SpaceTeam/STS1_EPS_PROTO/STS1_EPS/STS1_EPS_PROTO_BCC_LTC4020/STS1_EPS_PROTO_BCC_LTC4020.kicad_pcb

## KiCad design STS1_EPS/STS1_EPS_PROTO_BCC_LTC4020/STS1_EPS_PROTO_BCC_LTC4020.kicad_pcb (2021-07-15)

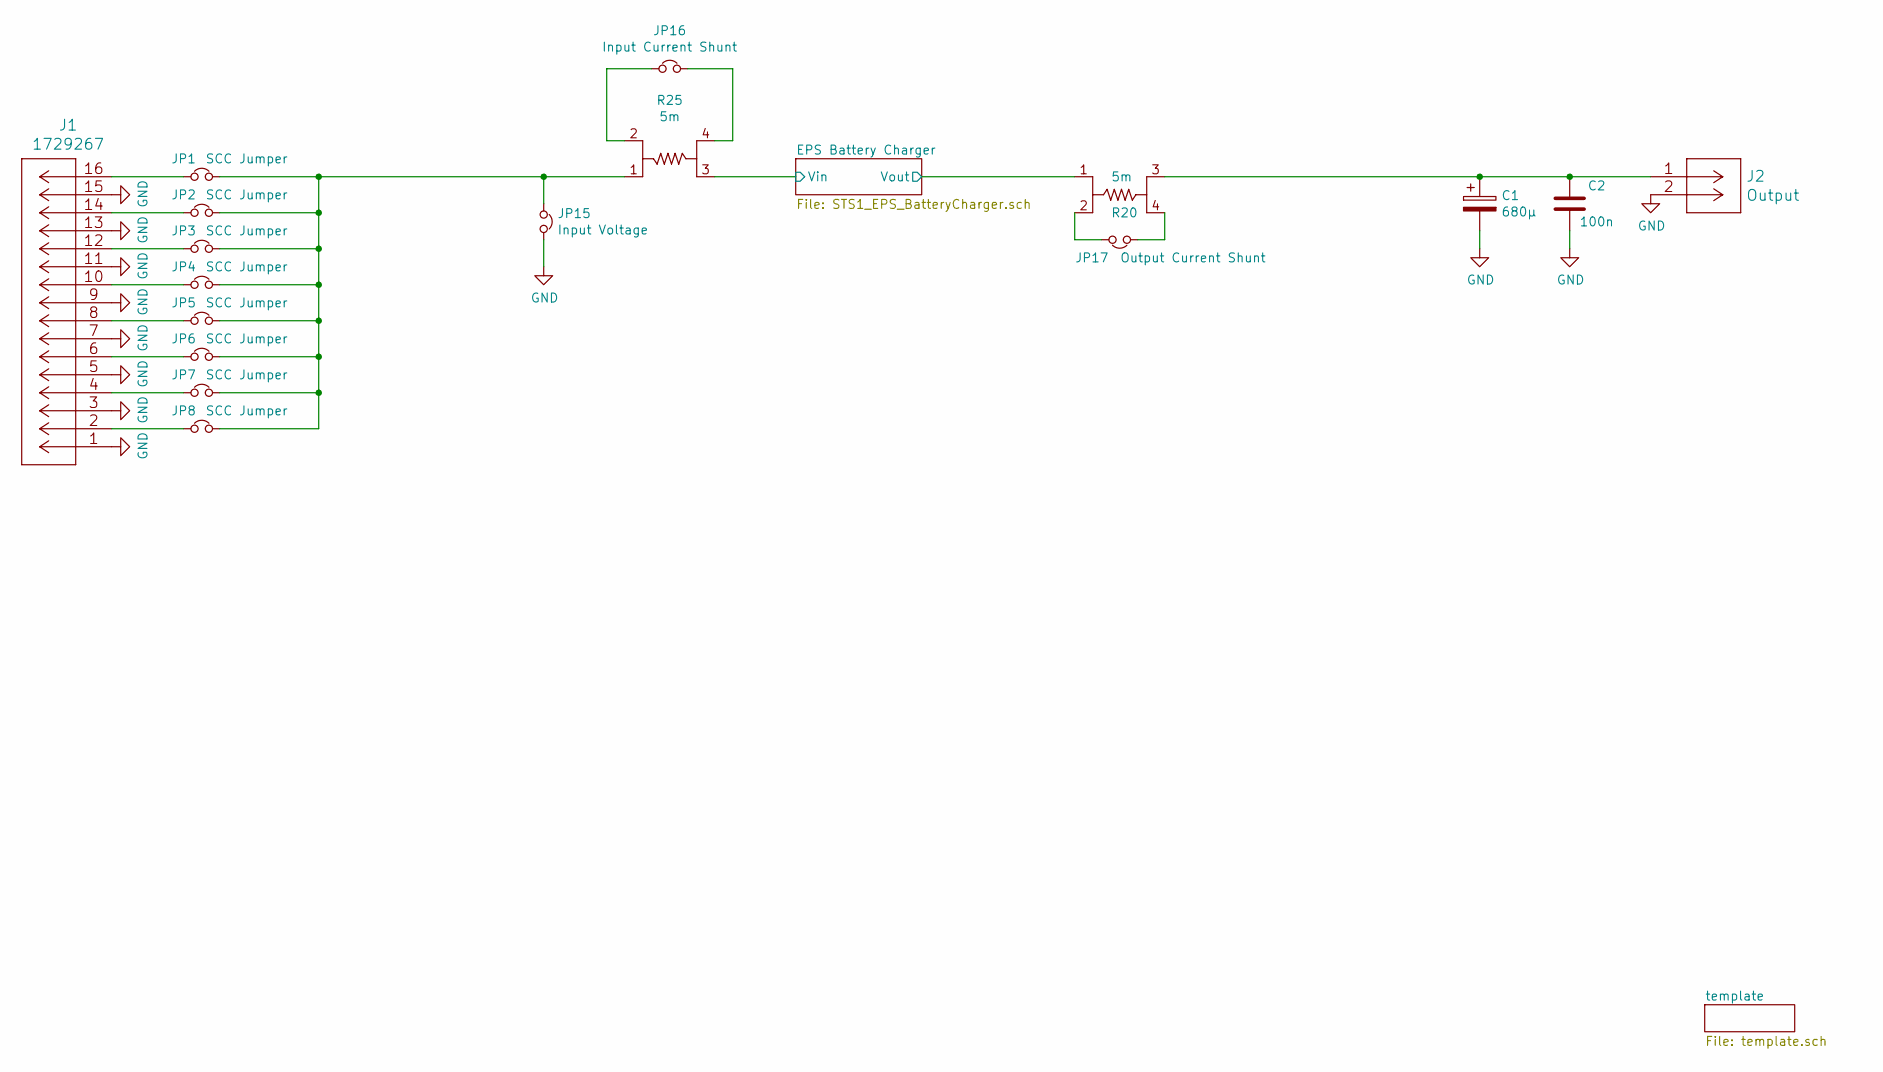
[picture p1: schematic STS1_EPS_PROTO_BCC_LTC4020.sch]

Parts:
C1: 680µ; CP_EIA-7361-438_AVX-U
C2: 100n; C_0805_2012Metric
J1: 1729267; 1984756
J2: Output; 1888807
JP1, JP2, JP3, JP4, JP5, JP6, JP7, JP8: SCC Jumper; PinHeader_1x02_P2.54mm_Vertical
JP15: Input Voltage; PinHeader_1x02_P2.54mm_Vertical
JP16: Input Current Shunt; PinHeader_1x02_P2.54mm_Vertical
JP17: Output Current Shunt; PinHeader_1x02_P2.54mm_Vertical
R20, R25: 5m; CST0612-FC-R002E

Connections:
/EPS Battery Charger/Vin: R25.3; also elsewhere on the board
/EPS Battery Charger/Vout: R20.1; also elsewhere on the board
GND: C1.2, C2.1, J1.1, J1.3, J1.5, J1.7, J1.9, J1.11, J1.13, J1.15, J2.2, JP15.2; also elsewhere on the board
unnamed: C1.1, C2.2, J2.1, R20.3
unnamed: J1.2, JP8.1
unnamed: J1.4, JP7.1
unnamed: J1.6, JP6.1
unnamed: J1.8, JP5.1
unnamed: J1.10, JP4.1
unnamed: J1.12, JP3.1
unnamed: J1.14, JP2.1
unnamed: J1.16, JP1.1
unnamed: JP1.2, JP2.2, JP3.2, JP4.2, JP5.2, JP6.2, JP7.2, JP8.2, JP15.1, R25.1
unnamed: JP16.1, R25.2
unnamed: JP16.2, R25.4
unnamed: JP17.1, R20.4
unnamed: JP17.2, R20.2

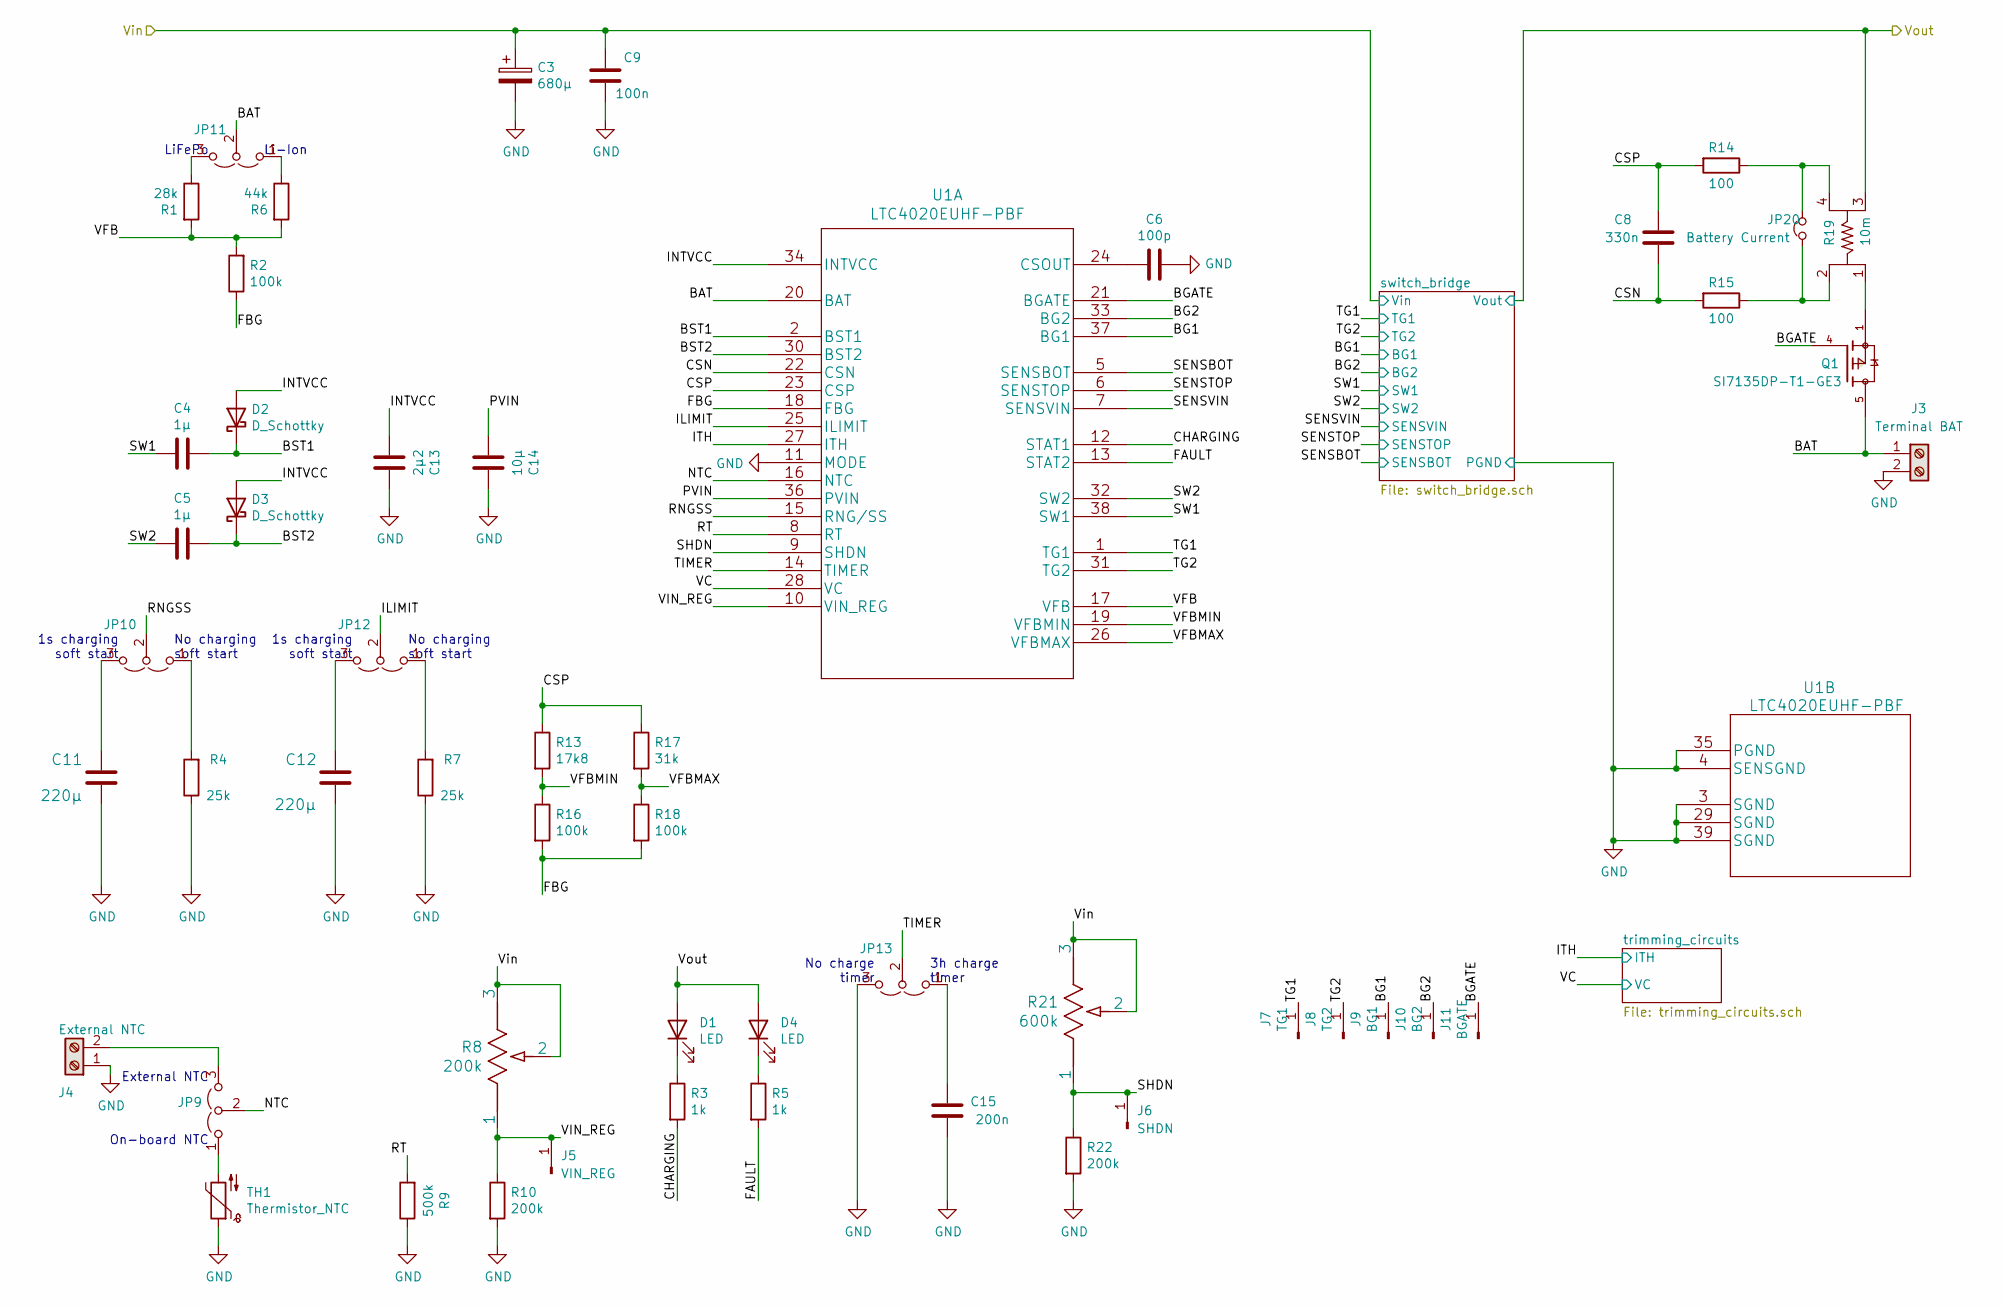
[picture p2: schematic STS1_EPS_BatteryCharger.sch, EPS Battery Charger]

Parts:
C3: 680µ; CP_EIA-7361-438_AVX-U
C4, C5: 1µ; C_0805_2012Metric
C6: 100p; C_0805_2012Metric
C8: 330n; C_0805_2012Metric
C9: 100n; C_0805_2012Metric
C11, C12: 220µ; CP_EIA-3528-12_Kemet-T
C13: 2µ2; C_0805_2012Metric
C14: 10µ; C_0805_2012Metric
C15: 200n; C_0805_2012Metric
D1, D4: LED; LED_0805_2012Metric
D2, D3: D_Schottky; RB168MM-40TFTR
J3: Terminal BAT; 1725656
J4: External NTC; 1725656
J5: VIN_REG; PinHeader_1x01_P2.54mm_Vertical
J6: SHDN; PinHeader_1x01_P2.54mm_Vertical
J7: TG1; PinHeader_1x01_P2.54mm_Vertical
J8: TG2; PinHeader_1x01_P2.54mm_Vertical
J9: BG1; PinHeader_1x01_P2.54mm_Vertical
J10: BG2; PinHeader_1x01_P2.54mm_Vertical
J11: BGATE; PinHeader_1x01_P2.54mm_Vertical
JP9, JP10, JP11, JP12, JP13: Jumper_3_Open; PinHeader_1x03_P2.54mm_Vertical
JP20: Battery Current; PinHeader_1x02_P2.54mm_Vertical
Q1: SI7135DP-T1-GE3; TRANS_SI7135DP-T1-GE3; PARTREV A
R1: 28k; R_0805_2012Metric
R2, R16, R18: 100k; R_0805_2012Metric
R3, R5: 1k; R_0805_2012Metric
R4, R7: 25k; R_0805_2012Metric
R6: 44k; R_0805_2012Metric
R8: 200k; TS53YL 20K 20&percent_
R9: 500k; R_0805_2012Metric
R10, R22: 200k; R_0805_2012Metric
R13: 17k8; R_0805_2012Metric
R14, R15: 100; R_0805_2012Metric
R17: 31k; R_0805_2012Metric
R19: 10m; CST0612-FC-R002E
R21: 600k; TS53YL 20K 20&percent_
TH1: Thermistor_NTC; R_0603_1608Metric
U1: LTC4020EUHF-PBF

Connections:
/EPS Battery Charger/BAT: J3.1, JP11.2 (C), Q1.5, U1.20 (BAT)
/EPS Battery Charger/BG1: J9.1, U1.37 (BG1); also elsewhere on the board
/EPS Battery Charger/BG2: J10.1, U1.33 (BG2); also elsewhere on the board
/EPS Battery Charger/BGATE: J11.1, Q1.4, U1.21 (BGATE)
/EPS Battery Charger/BST1: C4.1, D2.1 (K), U1.2 (BST1)
/EPS Battery Charger/BST2: C5.1, D3.1 (K), U1.30 (BST2)
/EPS Battery Charger/CHARGING: R3.2, U1.12 (STAT1)
/EPS Battery Charger/CSN: C8.2, R15.2, U1.22 (CSN)
/EPS Battery Charger/CSP: C8.1, R13.1, R14.2, R17.1, U1.23 (CSP)
/EPS Battery Charger/FAULT: R5.2, U1.13 (STAT2)
/EPS Battery Charger/FBG: R2.1, R16.2, R18.2, U1.18 (FBG)
/EPS Battery Charger/ILIMIT: JP12.2 (C), U1.25 (ILIMIT)
/EPS Battery Charger/INTVCC: C13.2, D2.2 (A), D3.2 (A), U1.34 (INTVCC)
/EPS Battery Charger/ITH: U1.27 (ITH); also elsewhere on the board
/EPS Battery Charger/NTC: JP9.2 (C), U1.16 (NTC)
/EPS Battery Charger/PVIN: C14.2, U1.36 (PVIN)
/EPS Battery Charger/RNGSS: JP10.2 (C), U1.15 (RNG/SS)
/EPS Battery Charger/RT: R9.2, U1.8 (RT)
/EPS Battery Charger/SENSBOT: U1.5 (SENSBOT); also elsewhere on the board
/EPS Battery Charger/SENSTOP: U1.6 (SENSTOP); also elsewhere on the board
/EPS Battery Charger/SENSVIN: U1.7 (SENSVIN); also elsewhere on the board
/EPS Battery Charger/SHDN: J6.1, R21.1, R22.1, U1.9 (SHDN)
/EPS Battery Charger/SW1: C4.2, U1.38 (SW1); also elsewhere on the board
/EPS Battery Charger/SW2: C5.2, U1.32 (SW2); also elsewhere on the board
/EPS Battery Charger/TG1: J7.1, U1.1 (TG1); also elsewhere on the board
/EPS Battery Charger/TG2: J8.1, U1.31 (TG2); also elsewhere on the board
/EPS Battery Charger/TIMER: JP13.2 (C), U1.14 (TIMER)
/EPS Battery Charger/VC: U1.28 (VC); also elsewhere on the board
/EPS Battery Charger/VFB: R1.2, R2.2, R6.2, U1.17 (VFB)
/EPS Battery Charger/VFBMAX: R17.2, R18.1, U1.26 (VFBMAX)
/EPS Battery Charger/VFBMIN: R13.2, R16.1, U1.19 (VFBMIN)
/EPS Battery Charger/VIN_REG: J5.1, R8.1, R10.1, U1.10 (VIN_REG)
/EPS Battery Charger/Vin: C3.1, C9.2, R8.2, R8.3, R21.2, R21.3; also elsewhere on the board
/EPS Battery Charger/Vout: D1.2 (A), D4.2 (A), R19.3; also elsewhere on the board
GND: C3.2, C6.1, C9.1, C11.1, C12.1, C13.1, C14.1, C15.2, J3.2, J4.1, JP13.3 (B), R4.1, R7.1, R9.1, R10.2, R22.2, TH1.1, U1.3 (SGND), U1.4 (SENSGND), U1.11 (MODE), U1.29 (SGND), U1.35 (PGND), U1.39 (SGND); also elsewhere on the board
unnamed: C6.2, U1.24 (CSOUT)
unnamed: C11.2, JP10.3 (B)
unnamed: C12.2, JP12.3 (B)
unnamed: C15.1, JP13.1 (A)
unnamed: D1.1 (K), R3.1
unnamed: D4.1 (K), R5.1
unnamed: J4.2, JP9.3 (B)
unnamed: JP9.1 (A), TH1.2
unnamed: JP10.1 (A), R4.2
unnamed: JP11.1 (A), R6.1
unnamed: JP11.3 (B), R1.1
unnamed: JP12.1 (A), R7.2
unnamed: JP20.1, R15.1, R19.2
unnamed: JP20.2, R14.1, R19.4
unnamed: Q1.1, R19.1

Notes on the sheet:
LiFePo
Li-Ion
No charge timer
3h charge timer
External NTC
On-board NTC
No charging soft start
1s charging soft start

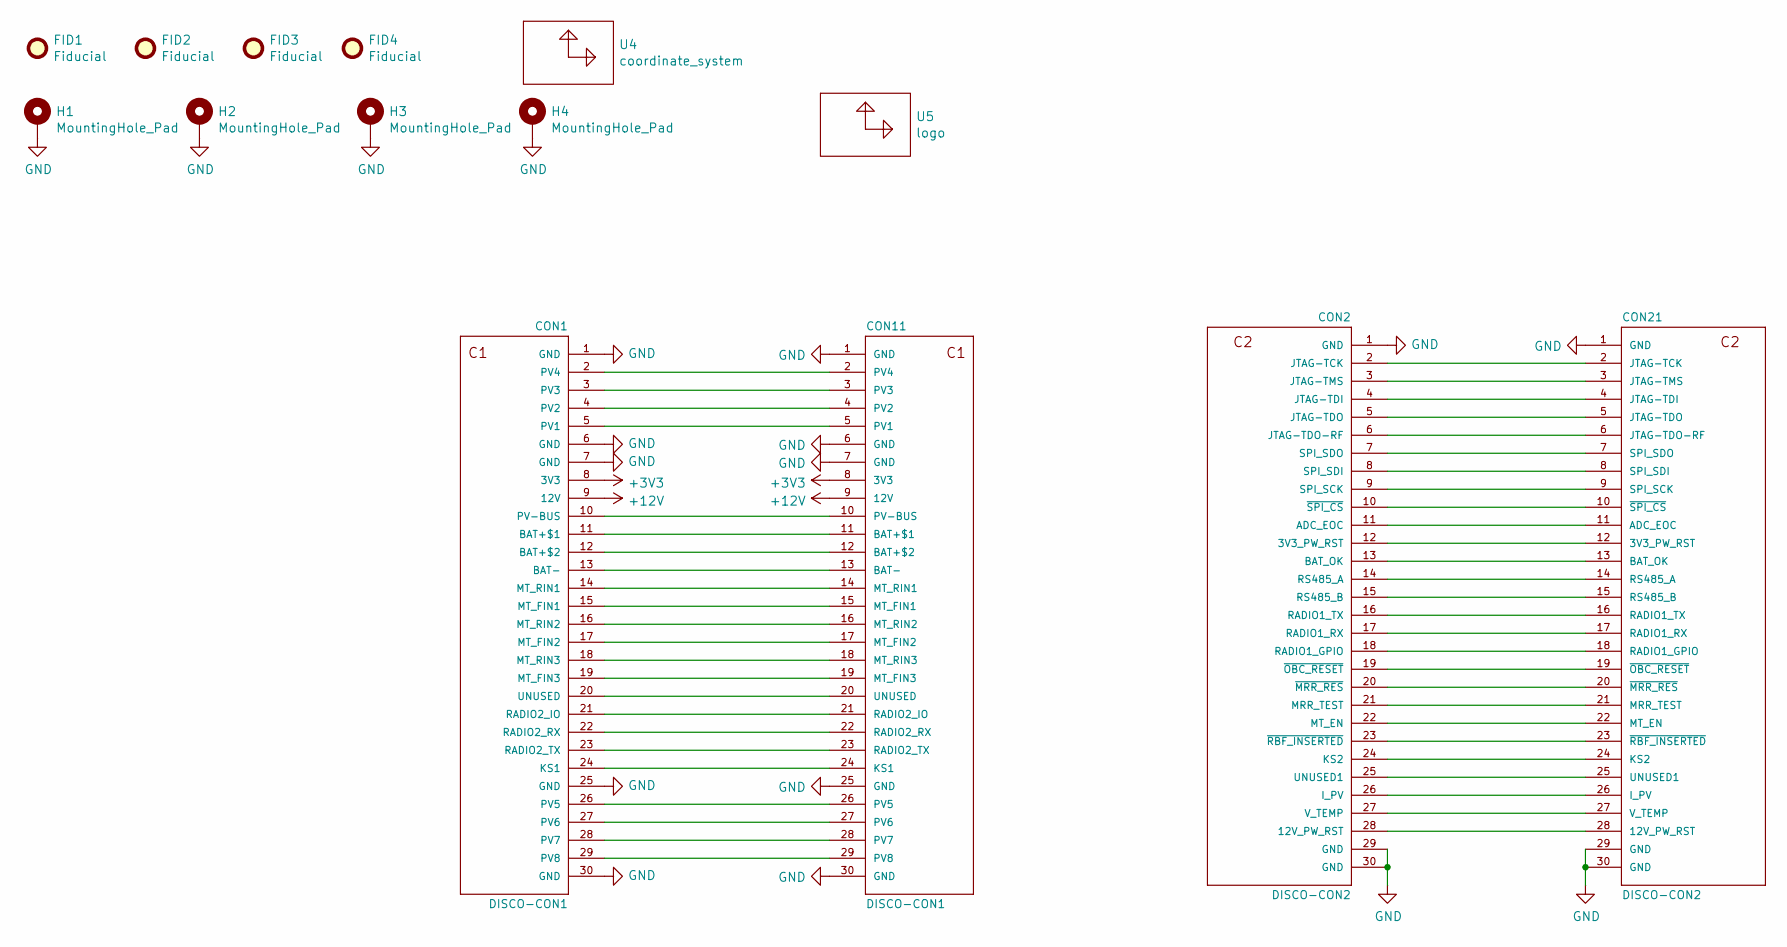
[picture p3: schematic template.sch]

Parts:
CON1, CON11: DISCO-CON1; Cubesatconnector
CON2, CON21: DISCO-CON2; Cubesatconnector
FID1, FID2, FID3, FID4: Fiducial; Fiducial_0.75mm_Mask1.5mm
H1, H2, H3, H4: MountingHole_Pad; MountingHole_3.2mm_M3_Pad_Via
U4: coordinate_system; Coordinates
U5: logo; STLogoTiny

Connections:
+3V3: CON1.8 (3V3), CON11.8 (3V3)
+12V: CON1.9 (12V), CON11.9 (12V)
GND: CON1.1 (GND), CON1.6 (GND), CON1.7 (GND), CON1.25 (GND), CON1.30 (GND), CON2.1 (GND), CON2.29 (GND), CON2.30 (GND), CON11.1 (GND), CON11.6 (GND), CON11.7 (GND), CON11.25 (GND), CON11.30 (GND), CON21.1 (GND), CON21.29 (GND), CON21.30 (GND), H1.1, H2.1, H3.1, H4.1; also elsewhere on the board
unnamed: CON1.2 (PV4), CON11.2 (PV4)
unnamed: CON1.3 (PV3), CON11.3 (PV3)
unnamed: CON1.4 (PV2), CON11.4 (PV2)
unnamed: CON1.5 (PV1), CON11.5 (PV1)
unnamed: CON1.10 (PV-BUS), CON11.10 (PV-BUS)
unnamed: CON1.11 (BAT+$1), CON11.11 (BAT+$1)
unnamed: CON1.12 (BAT+$2), CON11.12 (BAT+$2)
unnamed: CON1.13 (BAT-), CON11.13 (BAT-)
unnamed: CON1.14 (MT_RIN1), CON11.14 (MT_RIN1)
unnamed: CON1.15 (MT_FIN1), CON11.15 (MT_FIN1)
unnamed: CON1.16 (MT_RIN2), CON11.16 (MT_RIN2)
unnamed: CON1.17 (MT_FIN2), CON11.17 (MT_FIN2)
unnamed: CON1.18 (MT_RIN3), CON11.18 (MT_RIN3)
unnamed: CON1.19 (MT_FIN3), CON11.19 (MT_FIN3)
unnamed: CON1.20 (UNUSED), CON11.20 (UNUSED)
unnamed: CON1.21 (RADIO2_IO), CON11.21 (RADIO2_IO)
unnamed: CON1.22 (RADIO2_RX), CON11.22 (RADIO2_RX)
unnamed: CON1.23 (RADIO2_TX), CON11.23 (RADIO2_TX)
unnamed: CON1.24 (KS1), CON11.24 (KS1)
unnamed: CON1.26 (PV5), CON11.26 (PV5)
unnamed: CON1.27 (PV6), CON11.27 (PV6)
unnamed: CON1.28 (PV7), CON11.28 (PV7)
unnamed: CON1.29 (PV8), CON11.29 (PV8)
unnamed: CON2.2 (JTAG-TCK), CON21.2 (JTAG-TCK)
unnamed: CON2.3 (JTAG-TMS), CON21.3 (JTAG-TMS)
unnamed: CON2.4 (JTAG-TDI), CON21.4 (JTAG-TDI)
unnamed: CON2.5 (JTAG-TDO), CON21.5 (JTAG-TDO)
unnamed: CON2.6 (JTAG-TDO-RF), CON21.6 (JTAG-TDO-RF)
unnamed: CON2.7 (SPI_SDO), CON21.7 (SPI_SDO)
unnamed: CON2.8 (SPI_SDI), CON21.8 (SPI_SDI)
unnamed: CON2.9 (SPI_SCK), CON21.9 (SPI_SCK)
unnamed: CON2.10 (~SPI_CS), CON21.10 (~SPI_CS)
unnamed: CON2.11 (ADC_EOC), CON21.11 (ADC_EOC)
unnamed: CON2.12 (3V3_PW_RST), CON21.12 (3V3_PW_RST)
unnamed: CON2.13 (BAT_OK), CON21.13 (BAT_OK)
unnamed: CON2.14 (RS485_A), CON21.14 (RS485_A)
unnamed: CON2.15 (RS485_B), CON21.15 (RS485_B)
unnamed: CON2.16 (RADIO1_TX), CON21.16 (RADIO1_TX)
unnamed: CON2.17 (RADIO1_RX), CON21.17 (RADIO1_RX)
unnamed: CON2.18 (RADIO1_GPIO), CON21.18 (RADIO1_GPIO)
unnamed: CON2.19 (~OBC_RESET), CON21.19 (~OBC_RESET)
unnamed: CON2.20 (~MRR_RES), CON21.20 (~MRR_RES)
unnamed: CON2.21 (MRR_TEST), CON21.21 (MRR_TEST)
unnamed: CON2.22 (MT_EN), CON21.22 (MT_EN)
unnamed: CON2.23 (~RBF_INSERTED), CON21.23 (~RBF_INSERTED)
unnamed: CON2.24 (KS2), CON21.24 (KS2)
unnamed: CON2.25 (UNUSED1), CON21.25 (UNUSED1)
unnamed: CON2.26 (I_PV), CON21.26 (I_PV)
unnamed: CON2.27 (V_TEMP), CON21.27 (V_TEMP)
unnamed: CON2.28 (12V_PW_RST), CON21.28 (12V_PW_RST)

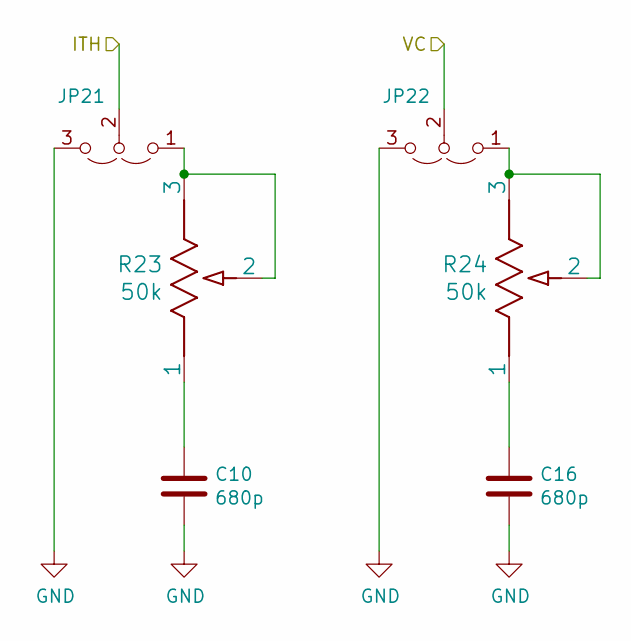
[picture p4: schematic trimming_circuits.sch]

Parts:
C10, C16: 680p; C_0805_2012Metric
JP21, JP22: Jumper_3_Open; PinHeader_1x03_P2.54mm_Vertical
R23, R24: 50k; TS53YL 20K 20&percent_

Connections:
/EPS Battery Charger/ITH: JP21.2 (C); also elsewhere on the board
/EPS Battery Charger/VC: JP22.2 (C); also elsewhere on the board
GND: C10.2, C16.2, JP21.3 (B), JP22.3 (B); also elsewhere on the board
unnamed: C10.1, R23.1
unnamed: C16.1, R24.1
unnamed: JP21.1 (A), R23.2, R23.3
unnamed: JP22.1 (A), R24.2, R24.3

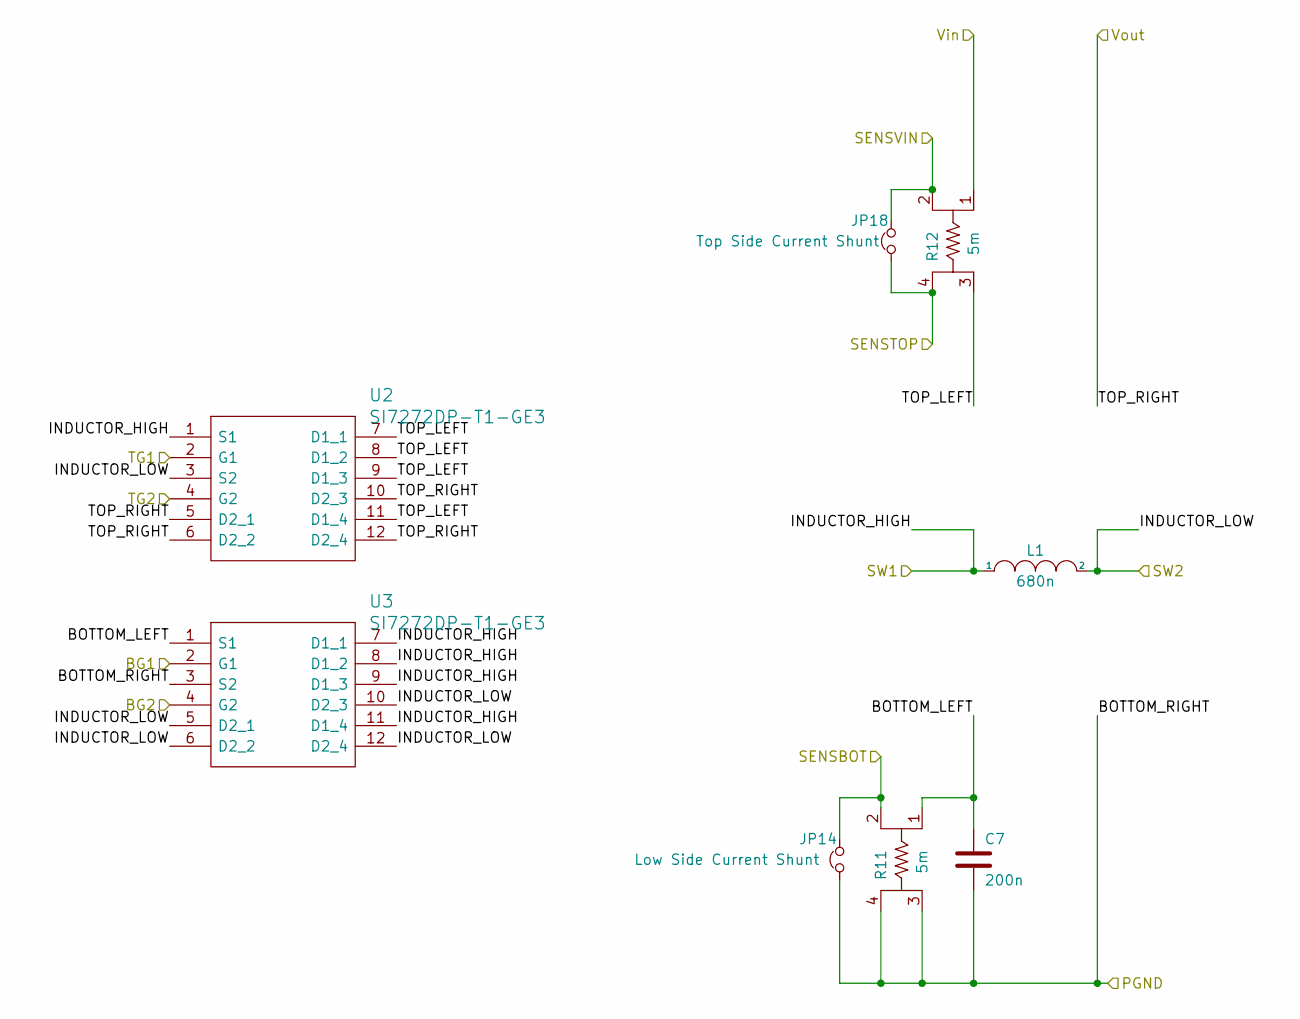
[picture p5: schematic switch_bridge.sch]

Parts:
C7: 200n; C_1812_4532Metric
JP14: Low Side Current Shunt; PinHeader_1x02_P2.54mm_Vertical
JP18: Top Side Current Shunt; PinHeader_1x02_P2.54mm_Vertical
L1: 680n; INDPM7366X500N
R11, R12: 5m; CST0612-FC-R002E
U2, U3: SI7272DP-T1-GE3; SI7288DPT1GE3

Connections:
/EPS Battery Charger/BG1: U3.2 (G1); also elsewhere on the board
/EPS Battery Charger/BG2: U3.4 (G2); also elsewhere on the board
/EPS Battery Charger/SENSBOT: JP14.2, R11.2; also elsewhere on the board
/EPS Battery Charger/SENSTOP: JP18.1, R12.4; also elsewhere on the board
/EPS Battery Charger/SENSVIN: JP18.2, R12.2; also elsewhere on the board
/EPS Battery Charger/SW1: L1.1, U2.1 (S1), U3.7 (D1_1), U3.8 (D1_2), U3.9 (D1_3), U3.11 (D1_4); also elsewhere on the board
/EPS Battery Charger/SW2: L1.2, U2.3 (S2), U3.5 (D2_1), U3.6 (D2_2), U3.10 (D2_3), U3.12 (D2_4); also elsewhere on the board
/EPS Battery Charger/TG1: U2.2 (G1); also elsewhere on the board
/EPS Battery Charger/TG2: U2.4 (G2); also elsewhere on the board
/EPS Battery Charger/Vin: R12.1; also elsewhere on the board
/EPS Battery Charger/Vout: U2.5 (D2_1), U2.6 (D2_2), U2.10 (D2_3), U2.12 (D2_4); also elsewhere on the board
/EPS Battery Charger/switch_bridge/BOTTOM_LEFT: C7.2, R11.1, U3.1 (S1)
/EPS Battery Charger/switch_bridge/TOP_LEFT: R12.3, U2.7 (D1_1), U2.8 (D1_2), U2.9 (D1_3), U2.11 (D1_4)
GND: C7.1, JP14.1, R11.3, R11.4, U3.3 (S2); also elsewhere on the board

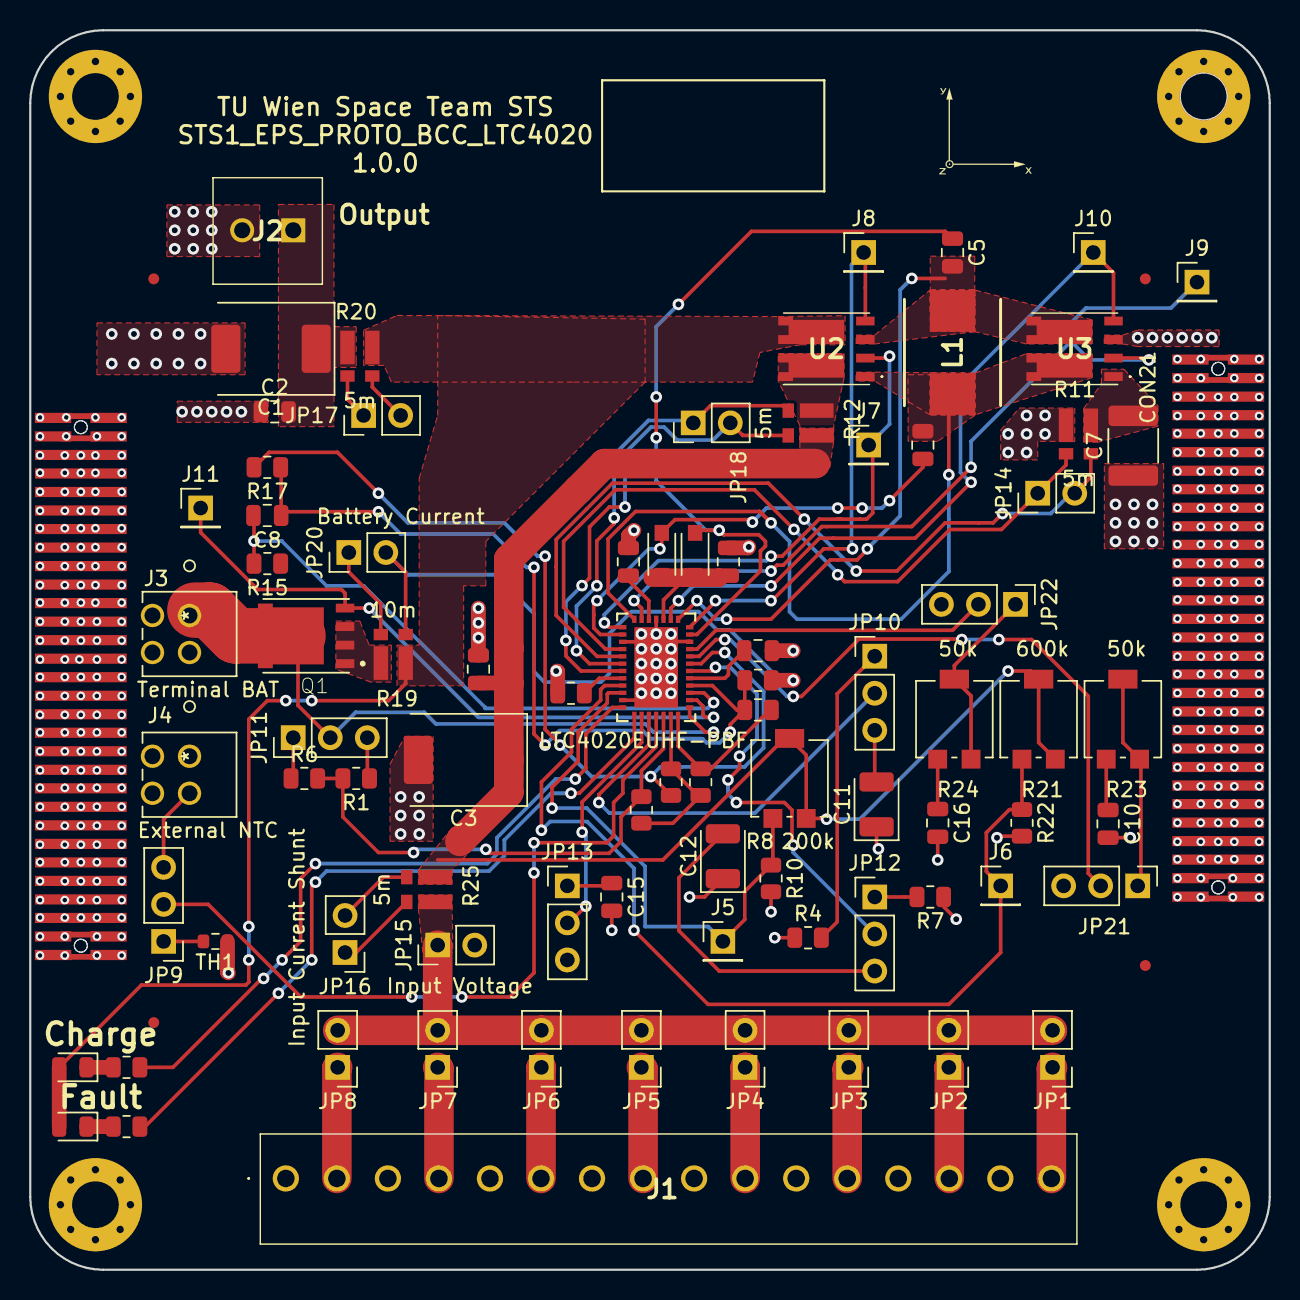
[picture p6: board STS1_EPS_PROTO_BCC_LTC4020.kicad_pcb from above]

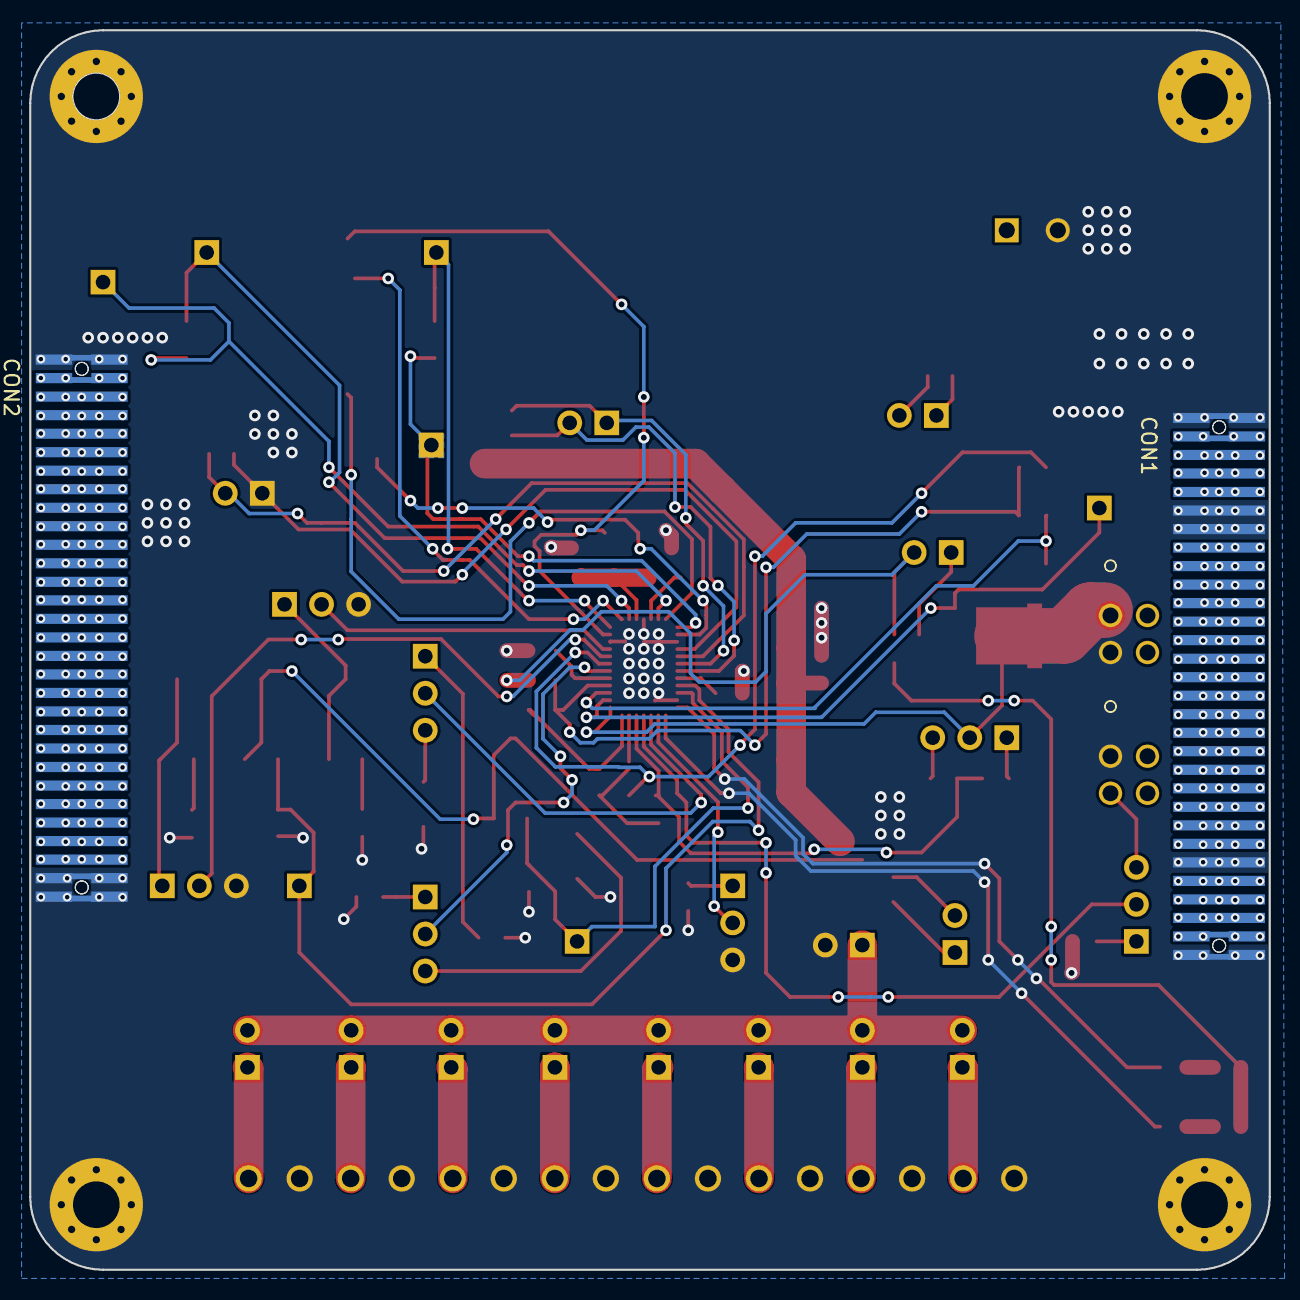
[picture p7: board STS1_EPS_PROTO_BCC_LTC4020.kicad_pcb from below]

Board: 2 copper layers, 85.0 x 85.0 mm, 96 parts (2 on the bottom side), 122 nets.
