SpaceTeam/STS1_EPS_PROTO/(commit log)

2021-06-25 Solar cell controller based on L6920d ready for reaview.
    [MPPT.sch, Overview.sch, STS1_EPS.kicad_pcb, STS1_EPS_BatteryCharger.sch, STS1_EPS_PROTO_SCC_L6920.kicad_pcb, STS1_EPS_PROTO_SCC_L6920.sch]
2021-06-27 Created project for LTC4020 Battery Charger prototype board.
    [Overview.sch, STS1_EPS.kicad_pcb, STS1_EPS_BatteryCharger.sch, STS1_EPS_PROTO_BCC_LTC4020.kicad_pcb, STS1_EPS_PROTO_BCC_LTC4020.sch]
2021-06-27 Added some missing KiCad library files.
    [MPPT.sch, Overview.sch, STS1_EPS.kicad_pcb, STS1_EPS_BatteryCharger.sch]
2021-06-27 Libraries should work again.
    [STS1_EPS_PROTO_SCC_L6920.kicad_pcb]
2021-06-27 Re-added battery charger schematic for STS1_EPS_PROTO_BCC_LTC4020 project.
    [STS1_EPS_BatteryCharger.sch, STS1_EPS_PROTO_BCC_LTC4020.kicad_pcb]
2021-06-28 Worked on STS1_EPS_PROTO_BCC_LTC4020 pcb.
    [STS1_EPS_PROTO_BCC_LTC4020.kicad_pcb]
2021-07-02 Reworked BCC
    [STS1_EPS_BatteryCharger.sch, STS1_EPS_PROTO_BCC_LTC4020.kicad_pcb, STS1_EPS_PROTO_BCC_LTC4020.sch]
2021-07-04 - STS1_EPS_PROTO_SCC_L6920 now uses the STS1 PCB template and is again ready for review. - WOrked on STS1_EPS_PROTO_BCC_LTC4020.
    [STS1_EPS_BatteryCharger.sch, STS1_EPS_PROTO_BCC_LTC4020.kicad_pcb, STS1_EPS_PROTO_BCC_LTC4020.sch, STS1_EPS_PROTO_SCC_L6920.kicad_pcb, STS1_EPS_PROTO_SCC_L6920.sch, template.sch, trimming_circuits.sch]
2021-07-12 Intermediate state.
    [STS1_EPS_BatteryCharger.sch, STS1_EPS_PROTO_BCC_LTC4020.kicad_pcb, STS1_EPS_PROTO_BCC_LTC4020.sch, STS1_EPS_PROTO_SCC_L6920.kicad_pcb, template.sch]
2021-07-15 BCC ready for review
    [STS1_EPS_PROTO_BCC_LTC4020.kicad_pcb]
